dhirdhir1997/Shuttlecock_throwing_robot_ABU_Robocon_2018/README.md

# Shuttlecock_throwing_robot_ABU_Robocon_2018

Built robots based on ABU Robocon 2018 competition theme
