dhirdhir1997/Shuttlecock_throwing_robot_ABU_Robocon_2018/Ultron_2/pinDef.h

#define sharpUPin -1
#define sharpDPin A5
#define sharpRPin A3
#define sharpLPin -1
#define sharpYPin -1
#define sharpXPin -1
#define sharpYPinAcc -1
#define sharpXPinAcc -1

#define uMotorPin 9
#define dMotorPin 6
#define rMotorPin 5
#define lMotorPin 4

#define baumer1Pin 34
#define baumer2Pin 36
#define baumer3Pin 38

#define stopBaumerPinDown 32
#define stopBaumerPinRight -1
#define stopBaumerPinLeft -1

#define pistonPin1 48
#define pistonPin2 41
#define pistonPin3 46
#define pistonPin4 39

#define breakingUpPin 43
#define breakingDownPin 47
#define breakingLeftPin 49
#define breakingRightPin 45

#define speedLimit 38
#define speedLimitSharp 35

#define addr 8
#define data 8

#define buzzerPin A0
#define ledPin A1


#define Speed 48
#define slowSpeed 28

#define leftHitSwitchPin 28
#define rightHitSwitchPin 30

#define xCamMid 120
#define yCamMid 160
