dhirdhir1997/Shuttlecock_throwing_robot_ABU_Robocon_2018/Eva/pinDef.h

#define flMotor_pin 8
#define frMotor_pin 6
#define rlMotor_pin 5
#define rrMotor_pin 4

#define piston1 37
#define piston2 -1
#define piston3 39


#define flMotor_pin_break 47
#define frMotor_pin_break 43
#define rlMotor_pin_break 45
#define rrMotor_pin_break 49
