dhirdhir1997/Shuttlecock_throwing_robot_ABU_Robocon_2018/Ultron_2/Master.ino

void getYourAssOutOfThere()
{
  recvVal();
  while(camDown !=  0)
  {
    moveRight(Speed);
    recvVal();
  }
  while(camDown ==  0)
  {
    moveRight(Speed);
    recvVal();
  }
  giveMeABreak(350);
}

void startbot(int val)
{
  recvVal();
  while(camDown !=  0)
  {
    moveRight(Speed);
    recvVal();
  }
  while(camDown ==  0)
  {
    moveRight(Speed);
    recvVal();
  }
  giveMeABreak(350);
  while(runTill(val))
  {
   recvVal();

    if(camUp != -1)
    {
      int tempDown = yCamMid - camDown;
      tempDown *= Kpc1;
      
      driveUp(-tempDown, true);
      driveDown(tempDown, true);
    }
   // alignY1Camnew();
  }
}

void makeWayForNoddy()
{
  
  if (mode == 1)
  {
    //Serial.println(downSharp());
    while(downSharp()>30)
    {
      alignX1Cam();
      moveLeft(Speed);
    }
    giveMeABreak(350);
    while(runTill(1500))
    {
      alignX1Cam();
    }
  }
  else if(mode == 2)
  {
    while(downSharp()<110)
    {
      alignX1Cam();
      moveRight(Speed);
    }
    giveMeABreak(350);
    while(rightSharp()<110)
      moveUp(Speed);
    giveMeABreak(350);
  }
}

int selectAZone()
{
  if(digitalRead(baumer1Pin)==HIGH)
    return 2;
  else if(digitalRead(baumer2Pin)==HIGH)
    return 3;
  else if(digitalRead(baumer3Pin)==HIGH)
    return 1;
  return 0;
}
void goRight()
{
  
    recvVal();
    while(camDown != 0)
    {
      alignX2Cam();
      moveRight(Speed);
      recvVal();
    }
    while(camDown == 0)
    {
      alignX2Cam();
      moveRight(Speed);
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
  }
  giveMeABreak(350);

/*
  while(runTill(3000))
  {
    moveUp(28);
  }
  giveMeABreak(300);*/
  while(runTill(1000))
  {
    moveUp(Speed-13);
  }
  while((rightHitSwitch() || leftHitSwitch())&&runTill(6000))
  {
      driveLeft(Speed-13, false);
      driveRight(-(Speed-13), false);
  }
}
