dhirdhir1997/Shuttlecock_throwing_robot_ABU_Robocon_2018/Eva/math.ino

float mapf(float x, float in_min, float in_max, float out_min, float out_max){  //mapping function for floating values.

  return ((((x - in_min) * (out_max - out_min)) / (in_max - in_min)) + out_min);
}
