dhirdhir1997/Shuttlecock_throwing_robot_ABU_Robocon_2018/NanpyI2C/ArduinoClass.h

#ifndef ARDUINO_CLASS
#define ARDUINO_CLASS

#include "BaseClass.h"
#include "MethodDescriptor.h"

namespace nanpy {
    class ArduinoClass : public BaseClass {

        public:
            void elaborate( nanpy::MethodDescriptor* m );
            const char* get_firmware_id();
            
    };
};

#endif
