dhirdhir1997/Shuttlecock_throwing_robot_ABU_Robocon_2018/Ultron_2/Clock.ino

bool runTill(int val)
{
  if (timer)
  {
    if (millis()-pervMilli<val)
      return true;
    else
    {
      timer = false;
      return false;
    }
  }
  else
  {
    pervMilli = millis();
    timer = true;
    return true;
  }
}
