dhirdhir1997/Shuttlecock_throwing_robot_ABU_Robocon_2018/Ultron_2/I2C.ino

void recvVal()
{ 
     Wire.requestFrom(addr, data);
     camUp = Wire.read()<<8|Wire.read();
     camDown = Wire.read()<<8|Wire.read();
     camRight = Wire.read()<<8|Wire.read();
     camLeft = Wire.read()<<8|Wire.read();
}
